swanmatch/Voyager60/foostan/readme.md

Cloned from https://github.com/foostan/kbd
Thanks foostan.
