swanmatch/Voyager60/local/Swanes.png

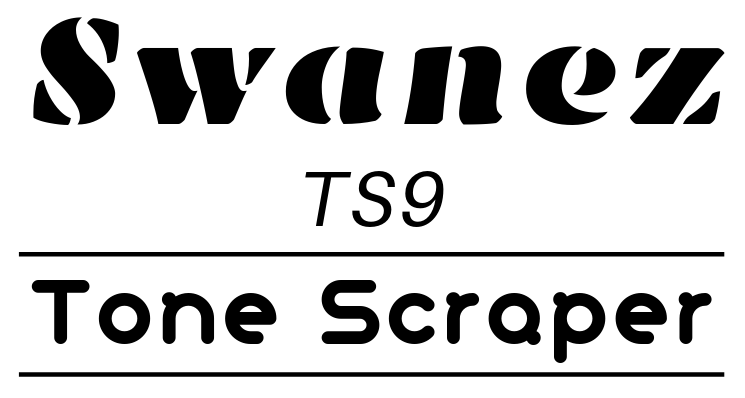
local/Swanes.png
