swanmatch/Voyager60/(list of files, drawings)

Other design files:
ts9.dsn
