swanmatch/Voyager60/ts9.kicad_pcb

## KiCad design ts9.kicad_pcb (2019-12-19)

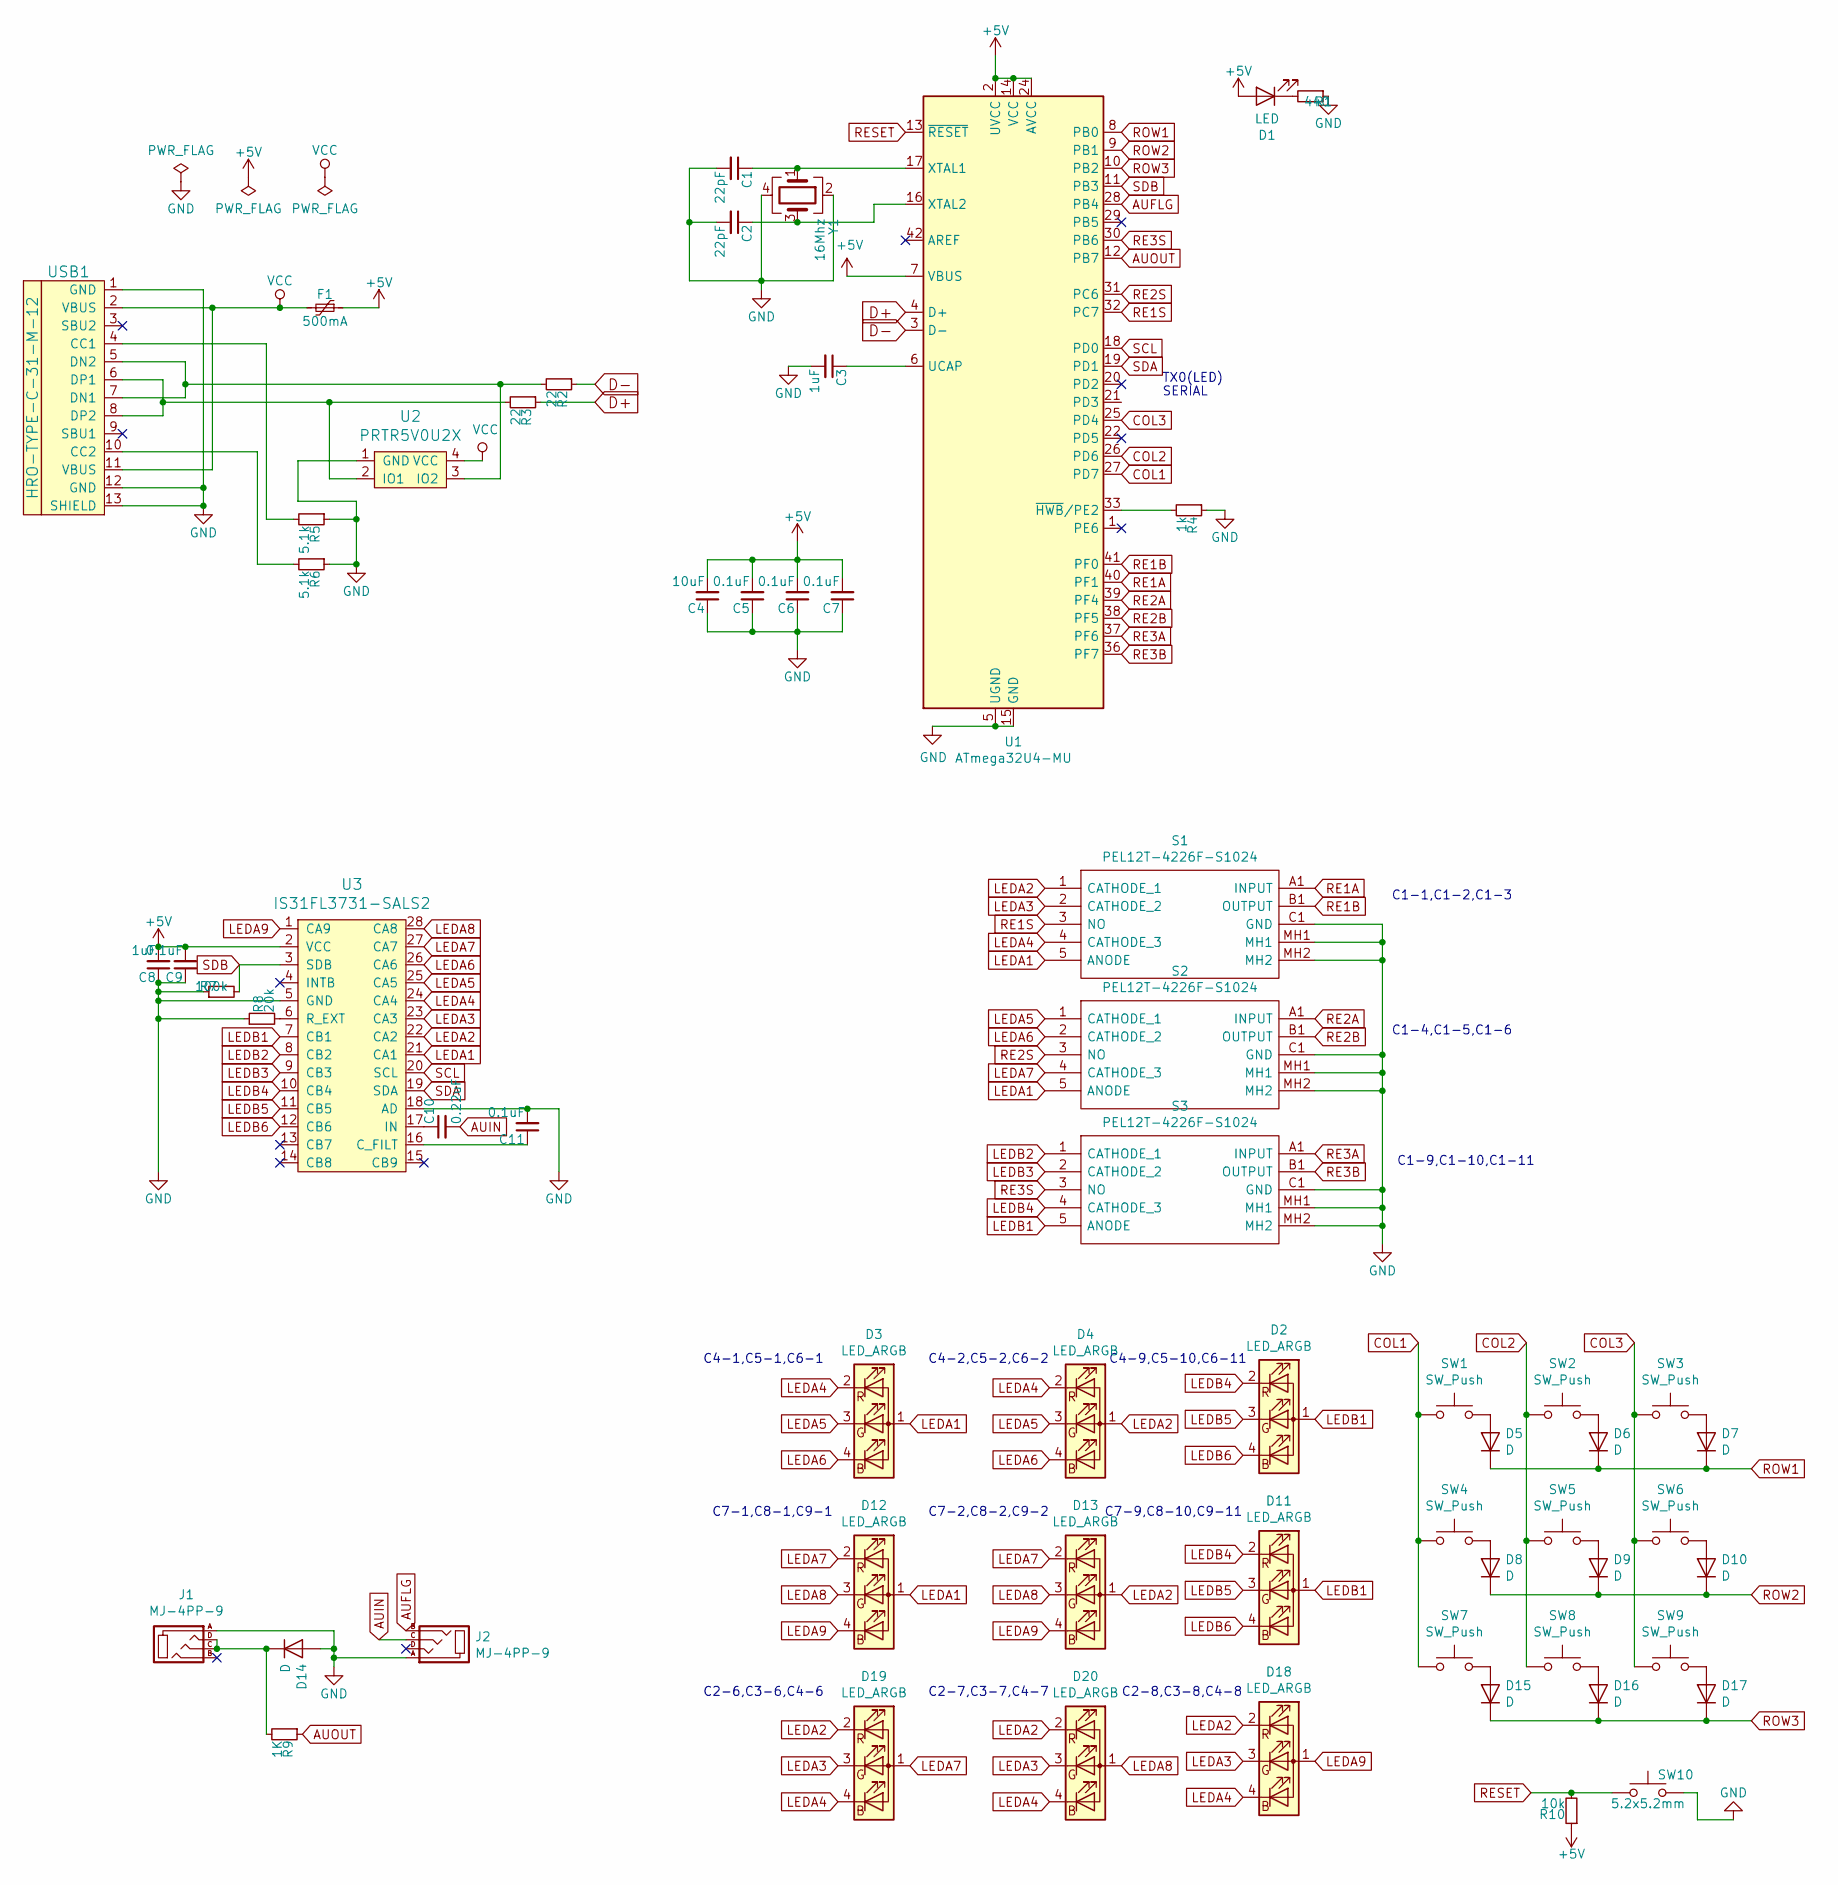
[picture p3: schematic ts9.sch]

Parts:
C1, C2: 22pF; C_0603
C3, C8: 1uF; C_0603
C4: 10uF; C_0603
C5, C6, C7, C9, C11: 0.1uF; C_0603
C10: 0.22uF; C_0603
D1: LED; LED_D3.0mm
D2, D3, D4, D11, D12, D13, D18, D19, D20: LED_ARGB; LED_Kingbright_AAA3528ESGCT
D5, D6, D7, D8, D9, D10, D14, D15, D16, D17: D; D_SOD-123
F1: 500mA; Fuse_SMD1206_Reflow
J1, J2: MJ-4PP-9; MJ-4PP-9_1side
R1: 440; R_0805
R2, R3: 22; R_0805
R4: 1k; R_0805
R5, R6: 5.1k; R_0805
R7: 100k; R_0805
R8: 20k; R_0805
R9: 1K; R_0805
R10: 10k; R_0805
S1, S2, S3: PEL12T-4226F-S1024; PEL12T4226FS1024; Manufacturer_Part_Number PEL12T-4226F-S1024; Mouser Part Number 652-PEL12T4226FS1024
SW1, SW2, SW3, SW4, SW5, SW6, SW7, SW8, SW9: SW_Push; PG1350
SW10: 5.2x5.2mm; ResetSW_1side
U1: ATmega32U4-MU; TQFP-44-1EP_10x10mm_Pitch0.8mm
U2: PRTR5V0U2X; SOT143B
U3: IS31FL3731-SALS2; SOP65P780X200-28N
USB1: HRO-TYPE-C-31-M-12; HRO-TYPE-C-31-M-12-Assembly
Y1: 16Mhz; Crystal_SMD_3225-4pin_3.2x2.5mm

Connections:
+5V: C4.2, C5.2, C6.2, C7.2, C8.2, C9.2, D1.2 (A), F1.1, R10.1, U1.2 (UVCC), U1.7 (VBUS), U1.14 (VCC), U1.24 (AVCC), U1.34 (VCC), U1.44 (AVCC), U3.2 (VCC)
AUFLG: J2.B, U1.28 (PB4)
AUIN: C10.2, J2.C
AUOUT: R9.1, U1.12 (PB7)
COL1: SW1.1, SW4.1, SW7.1, U1.27 (PD7)
COL2: SW2.1, SW5.1, SW8.1, U1.26 (PD6)
COL3: SW3.1, SW6.1, SW9.1, U1.25 (PD4)
D+: R3.1, U1.4 (D+)
D-: R2.1, U1.3 (D-)
GND: C1.2, C2.2, C3.2, C4.1, C5.1, C6.1, C7.1, C8.1, C9.1, C11.2, D14.2 (A), J1.A, J2.A, R1.1, R4.1, R5.1, R6.1, R7.1, R8.1, S1.C1 (GND), S1.MH1, S1.MH2, S2.C1 (GND), S2.MH1, S2.MH2, S3.C1 (GND), S3.MH1, S3.MH2, SW10.2, U1.5 (UGND), U1.15 (GND), U1.23 (GND), U1.35 (GND), U1.43 (GND), U1.45 (GND), U2.1 (GND), U3.5 (GND), U3.18 (AD), USB1.1 (GND), USB1.12 (GND), USB1.13 (SHIELD), Y1.2, Y1.4
LEDA1: D3.1 (A), D12.1 (A), S1.5 (ANODE), S2.5 (ANODE), U3.21 (CA1)
LEDA2: D4.1 (A), D13.1 (A), D18.2 (RK), D19.2 (RK), D20.2 (RK), S1.1 (CATHODE_1), U3.22 (CA2)
LEDA3: D18.3 (GK), D19.3 (GK), D20.3 (GK), S1.2 (CATHODE_2), U3.23 (CA3)
LEDA4: D3.2 (RK), D4.2 (RK), D18.4 (BK), D19.4 (BK), D20.4 (BK), S1.4 (CATHODE_3), U3.24 (CA4)
LEDA5: D3.3 (GK), D4.3 (GK), S2.1 (CATHODE_1), U3.25 (CA5)
LEDA6: D3.4 (BK), D4.4 (BK), S2.2 (CATHODE_2), U3.26 (CA6)
LEDA7: D12.2 (RK), D13.2 (RK), D19.1 (A), S2.4 (CATHODE_3), U3.27 (CA7)
LEDA8: D12.3 (GK), D13.3 (GK), D20.1 (A), U3.28 (CA8)
LEDA9: D12.4 (BK), D13.4 (BK), D18.1 (A), U3.1 (CA9)
LEDB1: D2.1 (A), D11.1 (A), S3.5 (ANODE), U3.7 (CB1)
LEDB2: S3.1 (CATHODE_1), U3.8 (CB2)
LEDB3: S3.2 (CATHODE_2), U3.9 (CB3)
LEDB4: D2.2 (RK), D11.2 (RK), S3.4 (CATHODE_3), U3.10 (CB4)
LEDB5: D2.3 (GK), D11.3 (GK), U3.11 (CB5)
LEDB6: D2.4 (BK), D11.4 (BK), U3.12 (CB6)
unnamed: C1.1, U1.17 (XTAL1), Y1.1
unnamed: C2.1, U1.16 (XTAL2), Y1.3
unnamed: C3.1, U1.6 (UCAP)
unnamed: C10.1, U3.17 (IN)
unnamed: C11.1, U3.16 (C_FILT)
unnamed: D1.1 (K), R1.2
unnamed: D5.2 (A), SW1.2
unnamed: D6.2 (A), SW2.2
unnamed: D7.2 (A), SW3.2
unnamed: D8.2 (A), SW4.2
unnamed: D9.2 (A), SW5.2
unnamed: D10.2 (A), SW6.2
unnamed: D14.1 (K), J1.C, J1.D, R9.2
unnamed: D15.2 (A), SW7.2
unnamed: D16.2 (A), SW8.2
unnamed: D17.2 (A), SW9.2
unnamed: R2.2, U2.3 (IO2), USB1.5 (DN2), USB1.7 (DN1)
unnamed: R3.2, U2.2 (IO1), USB1.6 (DP1), USB1.8 (DP2)
unnamed: R4.2, U1.33 (~HWB~/PE2)
unnamed: R5.2, USB1.4 (CC1)
unnamed: R6.2, USB1.10 (CC2)
unnamed: R8.2, U3.6 (R_EXT)
RE1A: S1.A1 (INPUT), U1.40 (PF1)
RE1B: S1.B1 (OUTPUT), U1.41 (PF0)
RE1S: S1.3 (NO), U1.32 (PC7)
RE2A: S2.A1 (INPUT), U1.39 (PF4)
RE2B: S2.B1 (OUTPUT), U1.38 (PF5)
RE2S: S2.3 (NO), U1.31 (PC6)
RE3A: S3.A1 (INPUT), U1.37 (PF6)
RE3B: S3.B1 (OUTPUT), U1.36 (PF7)
RE3S: S3.3 (NO), U1.30 (PB6)
RESET: R10.2, SW10.1, U1.13 (~RESET)
ROW1: D5.1 (K), D6.1 (K), D7.1 (K), U1.8 (PB0)
ROW2: D8.1 (K), D9.1 (K), D10.1 (K), U1.9 (PB1)
ROW3: D15.1 (K), D16.1 (K), D17.1 (K), U1.10 (PB2)
SCL: U1.18 (PD0), U3.20 (SCL)
SDA: U1.19 (PD1), U3.19 (SDA)
SDB: R7.2, U1.11 (PB3), U3.3 (SDB)
VCC: F1.2, U2.4 (VCC), USB1.2 (VBUS), USB1.11 (VBUS)

Notes on the sheet:
TX0(LED)
C1-1,C1-2,C1-3
C1-4,C1-5,C1-6
C1-9,C1-10,C1-11
C4-1,C5-1,C6-1
C7-1,C8-1,C9-1
C4-2,C5-2,C6-2
C7-2,C8-2,C9-2
C4-9,C5-10,C6-11
C7-9,C8-10,C9-11
C2-6,C3-6,C4-6
C2-7,C3-7,C4-7
C2-8,C3-8,C4-8
SERIAL

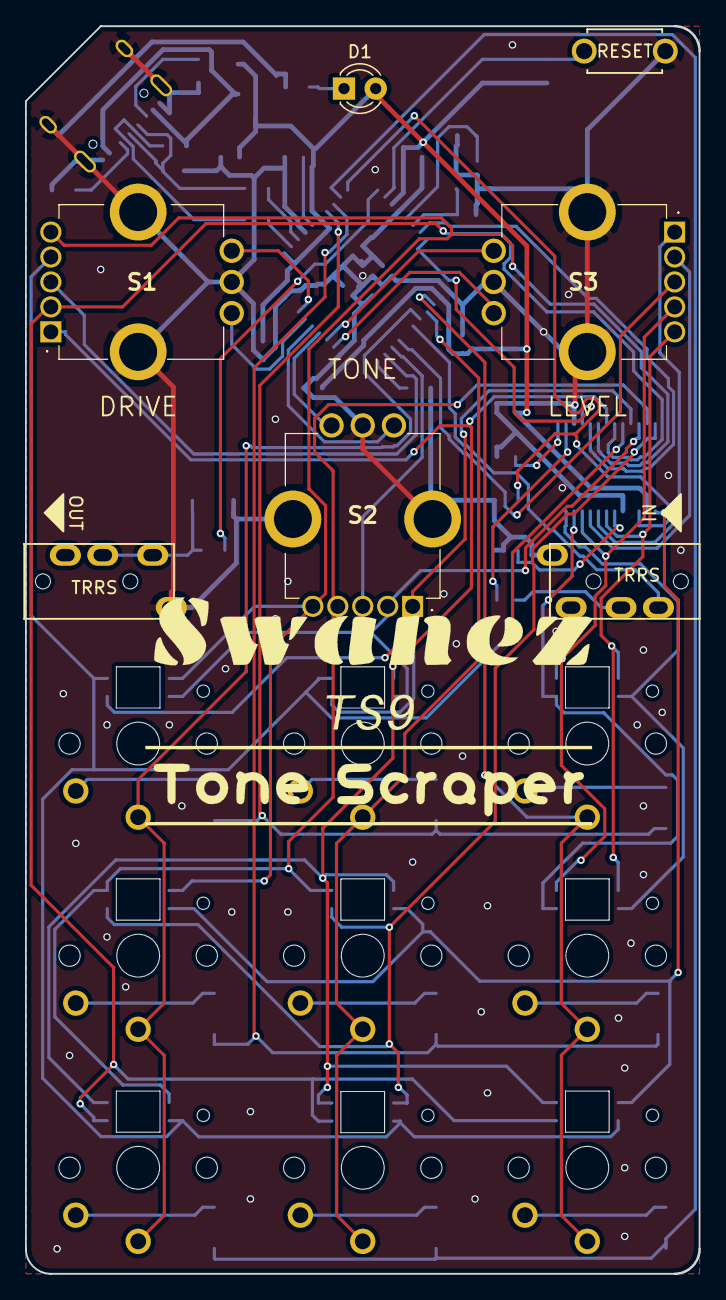
[picture p4: board ts9.kicad_pcb from above]

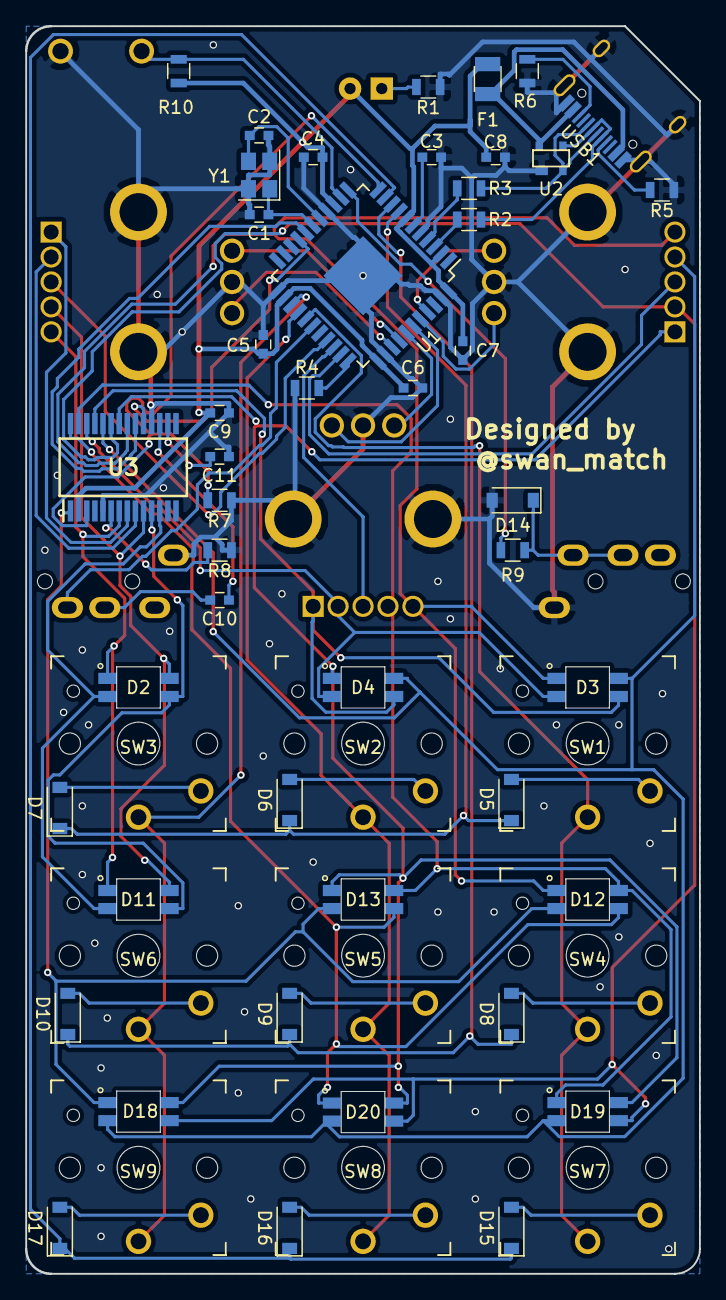
[picture p5: board ts9.kicad_pcb from below]

Board: 2 copper layers, 54.0 x 100.0 mm, 62 parts (46 on the bottom side), 64 nets.
