swanmatch/Voyager60/(commit log)

2019-12-19 first order
    [Voyager60-B.Cu.gbl, Voyager60-B.Fab.gbr, Voyager60-B.Mask.gbs, Voyager60-B.SilkS.gbo, Voyager60-Edge.Cuts.gm1, Voyager60-F.Cu.gtl, Voyager60-F.Fab.gbr, Voyager60-F.Mask.gts]
2020-02-24 review kobayuta
    [ts9.sch, ts9_bom_.csv]
